trash80/Ym2149Synth/Ym2149SynthSchematic-V29082016.pdf

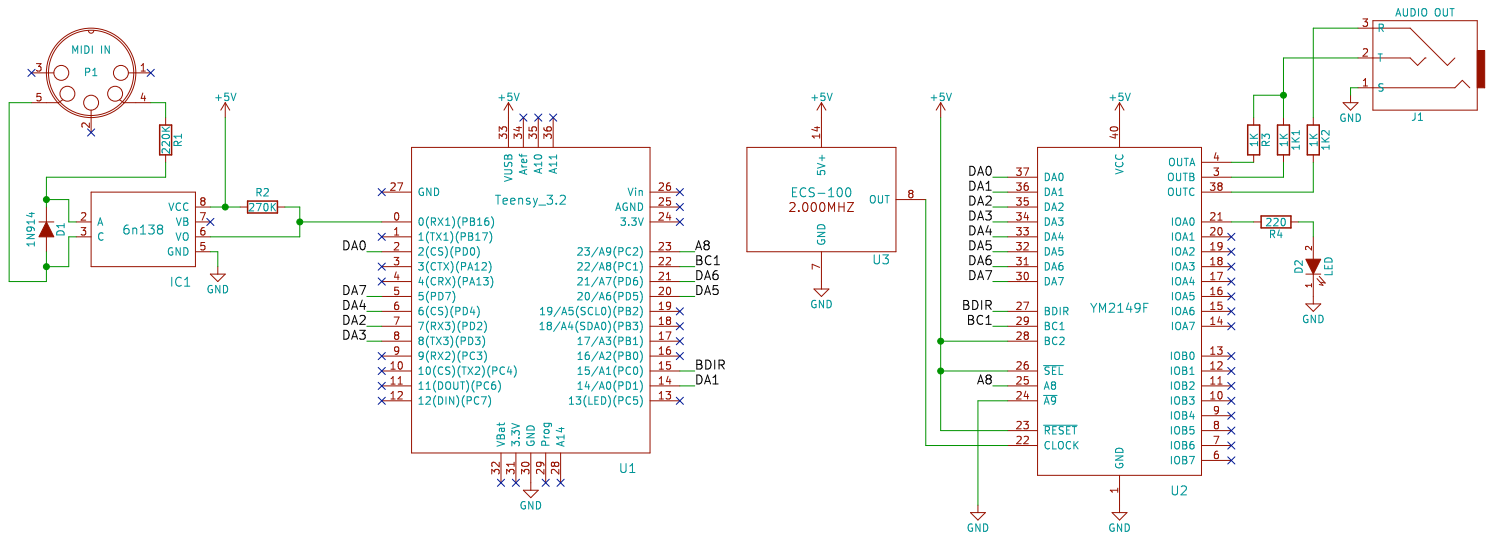
[picture p1: page 1]
