trash80/Ym2149Synth/Ym2149Synth/Ym2149Synth.ino

/*
 * Ym2149Synth
 * http://trash80.com
 * Copyright (c) 2016 Timothy Lamb
 *
 * This file is part of Ym2149Synth.
 *
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
 */

/*
 * Define BENCHMARK to run benchmarking (Look to method "benchmark" SynthController.cpp)
 */
//#define BENCHMARK 1

#include "MidiDeviceUsb.h"
#include "MidiDeviceSerial.h"
#include "SynthController.h"

SynthController synth;

MidiDeviceSerial midi(&Serial1);
MidiDeviceUsb usbMidi;

IntervalTimer samplerTimer;
IntervalTimer eventTimer;

const float sampleRate = 22050;
const float softSynthTimer = 1000000L/sampleRate;

void updateSoftSynth()
{
    synth.updateSoftSynths();
}

void updateEvents()
{
    synth.updateEvents();
}

void setup()
{
    pinMode(13,OUTPUT); // debug led on teensy

    synth.setChannels(1,2,3);
    synth.begin();

    usbMidi.setCallback(&synth);
    midi.setCallback(&synth);
    midi.begin();
#ifndef BENCHMARK
    samplerTimer.begin(updateSoftSynth, softSynthTimer);
    samplerTimer.priority(0);
    eventTimer.begin(updateEvents, 1000);
    eventTimer.priority(1);
#endif
}

void loop()
{
#ifndef BENCHMARK
    midi.update();
    usbMidi.update();
#else
    synth.benchmark();
#endif
}
