trash80/Ym2149Synth/Ym2149Synth/SynthVoice.cpp

/*
 * Ym2149Synth
 * http://trash80.com
 * Copyright (c) 2016 Timothy Lamb
 *
 * This file is part of Ym2149Synth.
 *
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
 */

 #include "SynthVoice.h"

/*
 *
 * ~~~~~ BEHOLD ALLMIGHTY JAVASCRIPT FOR TABLE GENERATION. ~~~
 * Run in a browser console.
 *
 * For YM pitch "freqTable":
 * function nf(n) {return Math.round((2000000.0/((Math.pow(2,(((n) - 69)/12)) * 440.0)))/16);};var out = [];for(var i =0; i<128; i += 0.1) out.push(nf(i));copy(out.toString());console.log("Data in copybuffer. Array size is "+out.length);
 *
 * For SoftSynth pitch "softFreqTable":
 * function nf(n) {return Math.round((Math.pow(2,(((n) - 69)/12)) * 440.0) * (1.0/22050) * 100000);};var out = [];for(var i =0; i<128; i += 0.1) out.push(nf(i));copy(out.toString());console.log("Data in copybuffer. Array size is "+out.length);
 *
 * For Volume Envelope Table :
 * size=256;function nf(n) {return Math.round(Math.pow(n, 1.75) * 255);};var out = [];for(var i =0; i<size; i += 1) out.push(nf(i/size));copy(out.toString());console.log("Data in copybuffer. Array size is "+out.length);
 *
*/
//@TODO document this class
//@TODO resize these arrays to only include notes that are playable
const static uint16_t tableSize = 1281;
const static uint16_t freqTable[tableSize] = {
    15289,15201,15113,15026,14940,14854,14768,14683,14599,14515,14431,14348,14265,14183,14101,14020,13939,13859,13779,13700,13621,13543,13465,13387,13310,13233,13157,13081,13006,12931,12856,12782,12709,12636,12563,12490,12419,12347,12276,12205,12135,12065,11996,11926,11858,11789,11722,11654,11587,11520,11454,11388,11322,11257,11192,11128,11064,11000,10937,10874,10811,10749,10687,10625,10564,10503,10443,10383,10323,10263,10204,10145,10087,10029,9971,9914,9857,9800,9743,9687,9631,9576,9521,9466,9411,9357,9303,9250,9197,9144,9091,9039,8986,8935,8883,8832,8781,8731,8680,8630,8581,8531,8482,8433,8385,8336,8288,8241,8193,8146,8099,8052,8006,7960,7914,7869,7823,7778,7733,7689,7645,7600,7557,7513,7470,7427,7384,7342,7299,7257,7215,7174,7133,7092,7051,7010,6970,6930,6890,6850,6810,6771,6732,6693,6655,6617,6578,6541,6503,6465,6428,6391,6354,6318,6281,6245,6209,6174,6138,6103,6067,6033,5998,5963,5929,5895,5861,5827,5793,5760,5727,5694,5661,5629,5596,5564,5532,5500,5468,5437,5405,5374,5343,5313,5282,5252,5221,5191,5161,5132,5102,5073,5043,5014,4986,4957,4928,4900,4872,4844,4816,4788,4760,4733,4706,4679,4652,4625,4598,4572,4545,4519,4493,4467,4442,4416,4391,4365,4340,4315,4290,4266,4241,4217,4192,4168,4144,4120,4097,4073,4050,4026,4003,3980,3957,3934,3912,3889,3867,3844,3822,3800,3778,3757,3735,3713,3692,3671,3650,3629,3608,3587,3566,3546,3525,3505,3485,3465,3445,3425,3405,3386,3366,3347,3327,3308,3289,3270,3251,3233,3214,3196,3177,3159,3141,3123,3105,3087,3069,3051,3034,3016,2999,2982,29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
};

//@TODO fixed point, could be unsigned long
const static uint16_t softFreqTable[tableSize] = {
    37,37,38,38,38,38,38,39,39,39,39,40,40,40,40,40,41,41,41,41,42,42,42,42,43,43,43,43,44,44,44,44,45,45,45,45,46,46,46,46,47,47,47,48,48,48,48,49,49,49,49,50,50,50,51,51,51,52,52,52,52,53,53,53,54,54,54,55,55,55,56,56,56,57,57,57,58,58,58,59,59,59,60,60,60,61,61,61,62,62,62,63,63,63,64,64,65,65,65,66,66,66,67,67,68,68,68,69,69,70,70,70,71,71,72,72,72,73,73,74,74,75,75,75,76,76,77,77,78,78,79,79,79,80,80,81,81,82,82,83,83,84,84,85,85,86,86,87,87,88,88,89,89,90,90,91,91,92,92,93,93,94,95,95,96,96,97,97,98,98,99,100,100,101,101,102,102,103,104,104,105,105,106,107,107,108,109,109,110,110,111,112,112,113,114,114,115,116,116,117,118,118,119,120,120,121,122,123,123,124,125,125,126,127,128,128,129,130,131,131,132,133,134,134,135,136,137,138,138,139,140,141,142,142,143,144,145,146,147,147,148,149,150,151,152,153,154,154,155,156,157,158,159,160,161,162,163,164,165,166,166,167,168,169,170,171,172,173,174,175,176,177,178,179,180,182,183,184,185,186,187,188,189,190,191,192,193,195,196,197,198,199,200,201,203,204,205,206,207,209,210,211,212,213,215,216,217,218,220,221,222,224,225,226,227,229,230,231,233,234,235,237,238,240,241,242,244,245,247,248,249,251,252,254,255,257,258,260,261,263,264,266,267,269,270,272,274,275,277,278,280,282,283,285,287,288,290,292,293,295,297,298,300,302,304,305,307,309,311,312,314,316,318,320,322,323,325,327,329,331,333,335,337,339,341,343,345,347,349,351,353,355,357,359,361,363,365,367,369,372,374,376,378,380,382,385,387,389,391,394,396,398,401,403,405,408,410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
};

const static uint8_t volumeEnvelopeTable[256] = {
0,0,0,0,0,0,0,0,1,1,1,1,1,1,2,2,2,2,2,3,3,3,3,4,4,4,5,5,5,6,6,6,7,7,7,8,8,9,9,9,10,10,11,11,12,12,13,13,14,14,15,15,16,16,17,17,18,18,19,20,20,21,21,22,23,23,24,24,25,26,26,27,28,28,29,30,30,31,32,33,33,34,35,36,36,37,38,39,39,40,41,42,43,43,44,45,46,47,48,48,49,50,51,52,53,54,55,55,56,57,58,59,60,61,62,63,64,65,66,67,68,69,70,71,72,73,74,75,76,77,78,79,80,81,82,83,84,85,86,88,89,90,91,92,93,94,95,97,98,99,100,101,102,104,105,106,107,108,110,111,112,113,114,116,117,118,119,121,122,123,125,126,127,128,130,131,132,134,135,136,138,139,140,142,143,144,146,147,149,150,151,153,154,156,157,158,160,161,163,164,166,167,168,170,171,173,174,176,177,179,180,182,183,185,186,188,189,191,192,194,196,197,199,200,202,203,205,207,208,210,211,213,215,216,218,220,221,223,224,226,228,229,231,233,234,236,238,240,241,243,245,246,248,250,252,255
};

#define map_int16(x, in_min, in_max, out_min, out_max) ((x - in_min) * (out_max - out_min) / (in_max - in_min) + out_min)

void SynthVoice::begin(YM2149 * ym, uint8_t sy)
{
    Ym = ym;
    synth = sy;

    enableVoice = true;
    enableSoftsynth = true;

    Ym->setNoise(synth,0);
    Ym->setEnv(synth,0);
    volumeEnvelope.begin();
    pitchEnvelope.begin();

    volumeEnvelope.setShape(0x00);
    volumeEnvelope.setRange(0,31);
    volumeEnvelope.setLookupTable(volumeEnvelopeTable,255);

    pitchEnvelope.setShape(0x00);
    pitchEnvelope.setRange(0,0);

    synthType = 255;
    setSynthType(0);
}

void SynthVoice::updateSoftsynth()
{
    //@TODO optimize this, used fixed.h for fixed point math
    if(!enableSoftsynth || volume <= 0) {
        return;
    }

    softPhase += softIncrement;

    if(softPhase > 100000) softPhase -= 100000;
    if(softPhase < 0) softPhase += 100000;

    if(softPhase >= softWidth) {
        if(softWavPos) {
            softWavPos = 0;
            Ym->setVolume(synth,volume);
        }
    } else {
        if(!softWavPos) {
            softWavPos = 1;
            Ym->setVolume(synth,0);
        }
    }
}

void SynthVoice::updateEvents()
{
    //@TODO optimize this, used fixed.h for fixed point math
    uint16_t voiceF = currentNoteFreq+transpose;


    uint16_t envF = 0;
    uint16_t softF = 0;

    if(playing) {

        if(glideActive) {
            uint16_t destF  = noteFreq+transpose;
            glidePhase += glideIncrement;
            if(destF > voiceF) {
                voiceF += (glidePhase/1000);
                if(voiceF >= destF) {
                    lastNoteFreq = -1;
                    voiceF = destF;
                    currentNoteFreq = noteFreq;
                    glideActive = false;
                }
            } else {
                voiceF -= (glidePhase/1000);
                if(voiceF <= destF) {
                    lastNoteFreq = -1;
                    voiceF = destF;
                    currentNoteFreq = noteFreq;
                    glideActive = false;
                }
            }
        }

        if(bendWheel) {
            voiceF += bendWheel;
        }

        envF = softF = voiceF;

        if(vibratoAmount && currentNoteFreq) {
            vibratoPhase += vibratoIncrement;
            if(vibratoPhase > 10000) vibratoPhase -= 20000;
            if(vibratoPhase < -10000) vibratoPhase += 20000;
            voiceF += map_int16(((abs(vibratoPhase) * 2) - 10000), -10000, 10000, vibratoAmount*-1, vibratoAmount)/100;
        }

        if(pitchEnvAmount) {
            pitchEnvelope.update();
            uint16_t pitchEnvAmt = pitchEnvelope.read();
            voiceF += pitchEnvAmt;
        }

        if(voiceF != lastNoteFreq) {
            lastNoteFreq = voiceF;

            if(!voicePitchModOnly) {
                envF = softF = voiceF;
            }

            if(enableSoftsynth) {
                uint16_t sf = softF;
                if(enableSoftDetune) sf +=pwmFreq+softFreqDetune;
                if(sf>=tableSize) sf = tableSize-1;
                softIncrement = softFreqTable[sf];
            }

            if(enableEnv) {
                if(voicePitchModOnly) {
                    // Acid on the pitch Envelope
                    Ym->setTone(synth,freqTable[voiceF+(softFreqDetune>>1)]);
                    Ym->setTone(4,freqTable[envF+pwmFreq]);
                } else {
                    Ym->setTone(4,freqTable[voiceF+pwmFreq]);
                }
            } else if (enableVoice) {
                if(voicePitchModOnly) {
                    Ym->setTone(synth,freqTable[voiceF+(softFreqDetune>>1)]);
                } else {
                    Ym->setTone(synth,freqTable[voiceF]);
                }
            }
            if (enableNoise) {
                Ym->setTone(3,0x1F - (((uint8_t)(voiceF/10))>>2));
            }
        }

        if(volumeEnvelope.update()) {
            volume = volumeEnvelope.read();
            if(volume == 0 && volumeEnvelope.getShape() & 0x80) {
                playing = false;
            }
            if(!enableSoftsynth)
                Ym->setVolume(synth,volume);
        }

        if(noiseDelay && !noiseDelayTriggered) {
            noiseDelayPhase += 1;
            if(noiseDelayPhase >= noiseDelayIncrement) {
                noiseDelayPhase = 0;
                noiseDelayTriggered = true;
                if(!enableNoise) {
                    Ym->setNoise(synth,2);
                } else {
                    Ym->setNoise(synth,0);
                }
            }
        }
    }
}

void SynthVoice::playNote(uint8_t n, uint8_t v)
{
    //@TODO refactor this
    //@TODO use a new note buffer class for handling monophonic note behavior
    if(v) {
        velocity = v;
        note     = n;
        noteFreq = ((uint16_t)n)*10;


        if(playing == false) {
            volumeEnvelope.reset();
            volumeEnvelope.setRange(0,v>>3);
            currentNoteFreq = noteFreq;
            volume = -1;

            glidePhase = 0;
            glideActive= false;
        } else {
            if(glide) {
                if(glideActive) currentNoteFreq = lastNoteFreq;
                glideActive = true;
                glidePhase = 0;

                glideIncrement = (((uint32_t)abs(noteFreq - currentNoteFreq))*10000)/glide;
                if(!glideIncrement) glideIncrement = 1;
            } else {
                glideIncrement = 0;
                currentNoteFreq = noteFreq;
                glidePhase = 0;
                glideActive= false;
            }
        }

        pitchEnvelope.reset();

        if(softIncrement > 1) softIncrement = 1;
        if(softIncrement < 0) softIncrement = 0;

        if(!enableVoice) {
            Ym->setNote(synth,255);
        }

        if(enableNoise) {
            Ym->setNoise(synth,1);
        } else {
            noiseDelayTriggered = false;
            enableNoise = false;
            Ym->setNoise(synth,0);
        }
        noiseDelayPhase = 0;

        if(enableEnv) {
            Ym->setEnv(synth,1);
            Ym->setEnvShape(0,0,0,0);
            if(envType == 1) {
                Ym->setEnvShape(1,0,0,0);
            } else {
                Ym->setEnvShape(1,0,1,0);
            }
        }

        playing = true;
        lastNoteFreq = 0;
    } else if(n == note) {
        playing = false;
        volume = 0;
        if(enableEnv) {
            Ym->setEnv(synth,0);
        }
        Ym->setVolume(synth,0);
    }
}

void SynthVoice::setPitchbend(int v)
{
    // Plus / minus 2 notes (since we have glide)
    // v == -0x2000 to 0x2000
    bendWheel = (v>>2)/100;
}

void SynthVoice::setGlide(uint8_t v)
{
    //unsigned int ms = map(v, 0, 127, 0, 1000);
    glide = v;
    glide<<=6;
}

void SynthVoice::setVolumeEnvShape(uint8_t v)
{
    if(v == 64) v = 65;
    volumeEnvelope.setShape(v);
}

void SynthVoice::setPitchEnvShape(uint8_t v)
{
    pitchEnvelope.setShape(v);
}

void SynthVoice::setPitchEnvAmount(uint8_t v)
{
    pitchEnvAmount = v;
    pitchEnvAmount*= 10;
    pitchEnvelope.setRange(0,pitchEnvAmount);
}

void SynthVoice::setVibratoAmount(uint8_t v)
{
    vibratoAmount = v*100;
}

void SynthVoice::setVibratoFreq(uint8_t v)
{
    unsigned int ms = (pow(8000.0f,1.0f - ((float)v)/127.0f)) + 5;
    vibratoIncrement = (1.0f/ms)*10000;
}

void SynthVoice::setPwmFreq(uint8_t v)
{
    pwmFreq = v;

    if(synthType == 6) {
        softWidth = (((float)(pwmFreq)/255) + 0.5) * 100000;
    }
    if(playing) {
        lastNoteFreq = 0;
    }
}

void SynthVoice::setSoftDetune(uint8_t v)
{
    softFreqDetune = v;
    softFreqDetune *= 10;
    if(playing) {
        lastNoteFreq = 0;
    }
}

void SynthVoice::setNoiseDelay(uint8_t v)
{
    noiseDelay = v;
    v = 127 - v;
    noiseDelayIncrement = v<<1;
}

void SynthVoice::setTranspose(uint8_t v)
{
    if(!v) v = 64;
    transpose = (((int)v) - 64) * 10;
}

void SynthVoice::setSynthType(uint8_t v)
{
    if(v == synthType) return;

    synthType = v;

    if(enableNoise) Ym->setNoise(synth,0);
    if(enableEnv) Ym->setEnv(synth,0);

    enableVoice = false;
    enableSoftsynth = false;
    enableEnv   = false;
    envType     = 0;
    enableNoise = false;
    enableSoftDetune = false;
    voicePitchModOnly = false;

    switch(synthType)
    {
        case 0:
            enableVoice = true;
        break;
        case 1:
            voicePitchModOnly = true;
            enableVoice = true;
            enableEnv   = true;
            envType     = 1;
        break;
        case 2:
            voicePitchModOnly = true;
            enableVoice = true;
            enableEnv   = true;
            envType     = 2;
        break;
        case 3:
            enableVoice = false;
            enableEnv   = true;
            envType     = 2;
        break;
        case 4:
            enableVoice = false;
            enableEnv   = true;
            envType     = 1;
        break;
        case 5:
            enableVoice = true;
            enableSoftsynth = true;
            enableSoftDetune  = true;
            softWidth = 50000;
        break;
        case 6:
            enableVoice = true;
            enableSoftsynth = true;
            voicePitchModOnly = true;
            enableSoftDetune  = false;
            softWidth = (((float)(pwmFreq)/255) + 0.5) * 100000;
        break;
        case 7:
            enableNoise = true;
        break;
        default:
            enableVoice = true;
        break;
    }
    if(playing) {
        lastNoteFreq = 0;
        playing = false;
        playNote(note, velocity);
    }
}
