trash80/Ym2149Synth/YmSynth/YMSynthVoice.cpp

/*
 * YmSynth
 * http://trash80.com
 * Copyright (c) 2016 Timothy Lamb
 *
 * This file is part of YmSynth.
 *
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
 */

 #include "YMSynthVoice.h"

/*
 *
 * ~~~~~ BEHOLD ALLMIGHTY JAVASCRIPT FOR TABLE GENERATION. ~~~
 * Run in a browser console.
 *
 * For YM pitch "freqTable":
 * function nf(n) {return Math.round((2000000.0/((Math.pow(2,(((n) - 69)/12)) * 440.0)))/16);};var out = [];for(var i =0; i<128; i += 0.1) out.push(nf(i));copy(out.toString());console.log("Data in copybuffer. Array size is "+out.length);
 *
 * For SoftSynth pitch "softFreqTable":
 * function nf(n) {return Math.round((Math.pow(2,(((n) - 69)/12)) * 440.0) * (1.0/22050) * 1000000) / 1000000;};var out = [];for(var i =0; i<128; i += 0.1) out.push(nf(i));copy(out.toString());console.log("Data in copybuffer. Array size is "+out.length);
 *
*/
const static uint16_t tableSize = 1281;
const static uint16_t freqTable[tableSize] = {
    15289,15201,15113,15026,14940,14854,14768,14683,14599,14515,14431,14348,14265,14183,14101,14020,13939,13859,13779,13700,13621,13543,13465,13387,13310,13233,13157,13081,13006,12931,12856,12782,12709,12636,12563,12490,12419,12347,12276,12205,12135,12065,11996,11926,11858,11789,11722,11654,11587,11520,11454,11388,11322,11257,11192,11128,11064,11000,10937,10874,10811,10749,10687,10625,10564,10503,10443,10383,10323,10263,10204,10145,10087,10029,9971,9914,9857,9800,9743,9687,9631,9576,9521,9466,9411,9357,9303,9250,9197,9144,9091,9039,8986,8935,8883,8832,8781,8731,8680,8630,8581,8531,8482,8433,8385,8336,8288,8241,8193,8146,8099,8052,8006,7960,7914,7869,7823,7778,7733,7689,7645,7600,7557,7513,7470,7427,7384,7342,7299,7257,7215,7174,7133,7092,7051,7010,6970,6930,6890,6850,6810,6771,6732,6693,6655,6617,6578,6541,6503,6465,6428,6391,6354,6318,6281,6245,6209,6174,6138,6103,6067,6033,5998,5963,5929,5895,5861,5827,5793,5760,5727,5694,5661,5629,5596,5564,5532,5500,5468,5437,5405,5374,5343,5313,5282,5252,5221,5191,5161,5132,5102,5073,5043,5014,4986,4957,4928,4900,4872,4844,4816,4788,4760,4733,4706,4679,4652,4625,4598,4572,4545,4519,4493,4467,4442,4416,4391,4365,4340,4315,4290,4266,4241,4217,4192,4168,4144,4120,4097,4073,4050,4026,4003,3980,3957,3934,3912,3889,3867,3844,3822,3800,3778,3757,3735,3713,3692,3671,3650,3629,3608,3587,3566,3546,3525,3505,3485,3465,3445,3425,3405,3386,3366,3347,3327,3308,3289,3270,3251,3233,3214,3196,3177,3159,3141,3123,3105,3087,3069,3051,3034,3016,2999,2982,29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
    volumeEnvelope.setRange(0,15);

    pitchEnvelope.setShape(0x00);
    pitchEnvelope.setRange(0,255);

    synthType = 255;
    setSynthType(0);
}

void YMSynthVoice::updateSoftsynth()
{
    if(!enableSoftsynth || volume <= 0) {
        return;
    }

    softPhase += softIncrement;

    if(softPhase > 1) softPhase -= 1;
    if(softPhase < 0) softPhase += 1;

    if(softPhase >= softWidth) {
        if(softWavPos) {
            softWavPos = 0;
            Ym->setVolume(synth,volume);
        }
    } else {
        if(!softWavPos) {
            softWavPos = 1;
            Ym->setVolume(synth,0);
        }
    }
}

void YMSynthVoice::updateEvents()
{
    uint16_t f = currentFreq+transpose;

    if(playing) {
        if(glide && notePitch != currentFreq) {
            if(notePitch > currentFreq) {
                currentFreq += glideIncrement;
                if(currentFreq > notePitch) currentFreq = notePitch;
                f = currentFreq+transpose;
            } else if(notePitch < currentFreq) {
                currentFreq -= glideIncrement;
                if(currentFreq < notePitch) currentFreq = notePitch;
                f = currentFreq+transpose;
            }
        }

        if(vibratoAmount && currentFreq) {
            vibratoPhase += vibratoIncrement;
            if(vibratoPhase > 1) vibratoPhase -= 2;
            if(vibratoPhase < -1) vibratoPhase += 2;
            f += (((abs(vibratoPhase) * 2) - 1) * vibratoAmount);
        }

        if(pitchEnvAmount) {
            pitchEnvelope.update();
            float envAmt = pitchEnvelope.read();
            envAmt /=255.0f;
            if(pitchEnvelope.getShape() & 0x80) {
                envAmt *= pitchEnvAmount * 10;
            } else {
                envAmt = (1.0f - envAmt) * pitchEnvAmount * -10;
            }
            f += envAmt;
        }

        if(bendWheel) {
            f += (bendWheel * 10);
        }

        if(f != lastNoteFreq) {
            lastNoteFreq = f;

            if(enableSoftsynth) {
                uint16_t sf = f;
                if(enableSoftDetune) sf +=pwmFreq+softFreqDetune;
                if(sf>=tableSize) sf = tableSize-1;
                softIncrement = softFreqTable[sf];
            }

            if(enableVoice) {
                Ym->setTone(synth,freqTable[f]);
            }
            if(enableEnv) {
                Ym->setTone(4,freqTable[f+pwmFreq]);
            }
            if (enableNoise || noiseDelayTriggered) {
                Ym->setTone(3,31 - ((f/10)>>2));
            }
        }

        if(volumeEnvelope.update()) {
            volume = volumeEnvelope.read();
            if(volume == 0 && volumeEnvelope.getShape() & 0x80) {
                playing = false;
            }
            Ym->setVolume(synth,volume);
        }

        if(noiseDelay && !noiseDelayTriggered) {
            noiseDelayPhase += noiseDelayIncrement;
            if(noiseDelayPhase >= 1) {
                noiseDelayPhase = 0;
                noiseDelayTriggered = true;
                if(!enableNoise) {
                    Ym->setNoise(synth,1);
                } else {
                    Ym->setNoise(synth,0);
                }
            }
        }
    }
}

void YMSynthVoice::playNote(uint8_t n, uint8_t v)
{
    if(v) {
        velocity = v;
        note     = n;
        notePitch = ((uint16_t)n)*10;
        if(playing == false) {
            volumeEnvelope.reset();
            volumeEnvelope.setRange(0,v>>3);
            currentFreq = notePitch;
            volume = -1;
        } else {
            if(glide) {
                glideIncrement = abs(((int)notePitch) - currentFreq);
                glideIncrement *= glide;
            } else {
                glideIncrement = 0;
                currentFreq = notePitch;
            }
        }

        pitchEnvelope.reset();

        if(softIncrement > 1) softIncrement = 1;
        if(softIncrement < 0) softIncrement = 0;

        if(!enableVoice) {
            Ym->setNote(synth,255);
        }

        if(enableNoise) {
            Ym->setNoise(synth,1);
        } else {
            noiseDelayTriggered = false;
            enableNoise = false;
            Ym->setNoise(synth,0);
        }
        noiseDelayPhase = 0;

        if(enableEnv) {
            Ym->setEnv(synth,1);
            Ym->setEnvShape(0,0,0,0);
            if(envType == 1) {
                Ym->setEnvShape(1,0,0,0);
            } else {
                Ym->setEnvShape(1,0,1,0);
            }
        }

        playing = true;
        lastNoteFreq = 0;
    } else if(n == note) {
        playing = false;
        volume = 0;
        if(enableEnv) {
            Ym->setEnv(synth,0);
        }
        Ym->setVolume(synth,0);
    }
}

void YMSynthVoice::setPitchbend(int v)
{
    bendWheel = v;
    bendWheel /= 0x2000;
    bendWheel *= 2;
}

void YMSynthVoice::setGlide(uint8_t v)
{
    unsigned int ms = map(v, 0, 127, 0, 1000);
    glide = 1.0f/ms;
}

void YMSynthVoice::setPitchEnvelopeAmount(uint8_t v)
{
    pitchEnvAmount = v;
}

void YMSynthVoice::setVibratoAttack(uint8_t v)
{
    unsigned int ms = map(v, 0, 127, 0, 1000);
    vibratoDelayIncrement = 1.0f/ms;
}

void YMSynthVoice::setVibratoAmount(uint8_t v)
{
    vibratoAmount = v;
}

void YMSynthVoice::setVibratoFreq(uint8_t v)
{
    unsigned int ms = (pow(8000.0f,1.0f - ((float)v)/127.0f)) + 5;
    vibratoIncrement = 1.0f/ms;
}

void YMSynthVoice::setPwmFreq(uint8_t v)
{
    pwmFreq = v;

    if(synthType == 6) {
        softWidth = ((float)(pwmFreq)/255) + 0.5;
    }
    if(playing) {
        lastNoteFreq = 0;
    }
}

void YMSynthVoice::setSoftDetune(uint8_t v)
{
    softFreqDetune = v;
    softFreqDetune *= 10;
    if(playing) {
        lastNoteFreq = 0;
    }
}

void YMSynthVoice::setNoiseDelay(uint8_t v)
{
    noiseDelay = v;
    unsigned int ms = (pow(4000.0f,((float)v)/127.0f)) + 5;
    noiseDelayIncrement = 1.0f/ms;
}

void YMSynthVoice::setTranspose(uint8_t v)
{
    transpose = (((int)v) - 64) * 10;
}

void YMSynthVoice::setSynthType(uint8_t v)
{
    if(v == synthType) return;

    synthType = v;

    if(enableNoise) Ym->setNoise(synth,0);
    if(enableEnv) Ym->setEnv(synth,0);

    enableVoice = false;
    enableSoftsynth = false;
    enableEnv   = false;
    envType     = 0;
    enableNoise = false;
    enableSoftDetune = false;
    softShape   = 1;

    switch(synthType)
    {
        case 0:
            enableVoice = true;
        break;
        case 1:
            enableVoice = true;
            enableEnv   = true;
            envType     = 1;
        break;
        case 2:
            enableVoice = true;
            enableEnv   = true;
            envType     = 2;
        break;
        case 3:
            enableVoice = false;
            enableEnv   = true;
            envType     = 2;
        break;
        case 4:
            enableVoice = false;
            enableEnv   = true;
            envType     = 1;
        break;
        case 5:
            enableVoice = true;
            enableSoftsynth = true;
            enableSoftDetune  = true;
            softWidth = 0.5;
            softShape = 1;
        break;
        case 6:
            enableSoftsynth = true;
            softWidth = ((float)(pwmFreq)/255) + 0.5;
        break;
        case 7:
            enableNoise = true;
        break;
        default:
            enableVoice = true;
        break;
    }
    if(playing) {
        lastNoteFreq = 0;
        playing = false;
        playNote(note, velocity);
    }
}
