trash80/Ym2149Synth/Ym2149Synth/SynthSoftEnvelope.cpp

/*
 * Ym2149Synth
 * http://trash80.com
 * Copyright (c) 2016 Timothy Lamb
 *
 * This file is part of Ym2149Synth.
 *
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
 */

#define map_int16(x, in_min, in_max, out_min, out_max) (((int)x - (int)in_min) * ((int)out_max - (int)out_min) / ((int)in_max - (int)in_min) + (int)out_min)

#include "SynthSoftEnvelope.h"

//@TODO document this class

void SynthSoftEnvelopeClass::begin()
{
    phaseLength = 255;
}

bool SynthSoftEnvelopeClass::update()
{
    //@TODO add slope curve option, add a release state
    uint16_t was = value;

    if(!shape) {
        value = max;
        return value != was;
    }

    if(value == -1) {
        // Initialize and send start value
        value = 0;
        if(shape & 0x80) {
            value = (uint16_t) map_int16(value, 255, 0, min, max);
        } else {
            value = (uint16_t) map_int16(value, 0, 255, min, max);
        }

        return true;
    }

    tick-=1;
    if(tick > 0) {
        return false;
    }

    tick = size;
    if(phase < 255) {
        phase+=increment;
    }

    if(phase >= 255) {
        if(shape & 0x80) {
            value = min;
            return value != was;
        } else {
            value = max;
            return value != was;
        }
    }

    if(lookupSize) {
        value = lookupTable[phase];
    } else {
        value = phase;
    }
    if(shape & 0x80) {
        value = (uint16_t) map_int16(value,255, 0, min, max);
    } else {
        value = (uint16_t) map_int16(value,0, 255, min, max);
    }

    return value != was;
}

uint16_t SynthSoftEnvelopeClass::read()
{
    return value;
}

void SynthSoftEnvelopeClass::setRange(uint16_t mn, uint16_t mx)
{
    min = mn;
    max = mx;
}

uint8_t SynthSoftEnvelopeClass::getShape()
{
    return shape;
}

void SynthSoftEnvelopeClass::setShape(uint8_t v)
{
    shape = v<<1;
    size = (((((unsigned long)(shape&0x7F))<<5))/255);
    increment = 1;
    if(size == 0) {
        increment = 255/((shape&0x7F)<<5);
    }
}

void SynthSoftEnvelopeClass::setLookupTable(const uint8_t t[], uint8_t size)
{
    lookupTable = t;
    lookupSize = size;
}

void SynthSoftEnvelopeClass::reset()
{
    tick = size;
    phase = 0;
    value = -1;
}
