trash80/Ym2149Synth/(commit log)

2016-08-26 Pitchbend error in assigning to voice.
    [YMSynthController.cpp]
2016-08-26 Flipping midi map CCs for vibrato.
    [SynthController.cpp]
2016-08-27 Setting MIDI channels to 1,2,3, reset MIDI baud to 31250. (Was dubugging at 2000000)
    [Ym2149Synth.ino]
2016-08-29 Acid & cleaner volume control on PWM.
2016-08-29 Changing synth types to take advantage of voice pitch modulation only.
2016-08-29 Added schematic & KiCad project.
    [Ym2149Synth.kicad_pcb, Ym2149Synth.sch]
2016-08-30 Teensy 3.1 -> 3.2
    [Ym2149Synth.sch]
2016-08-30 Error on schematic. R2 misplaced.
    [Ym2149Synth.sch]
2016-08-31 Fix noise modes in YM2149 base.
    [YM2149.cpp]
2016-09-01 Error in schematic, 6n138 was on wrong output pin.
    [Ym2149Synth.sch]
2016-09-01 Ym debug led set to YM pin0
2017-07-24 Set custom midi device name
2017-07-24 Add support for patches on Teensy LC
2017-07-26 Update SynthPatchStorage.cpp
    Added back in the missing presets for Teensy 3.1
    [SynthPatchStorage.cpp]
